jimmyw/soldering_station/solderingcontroller/solderingcontroller.pdf

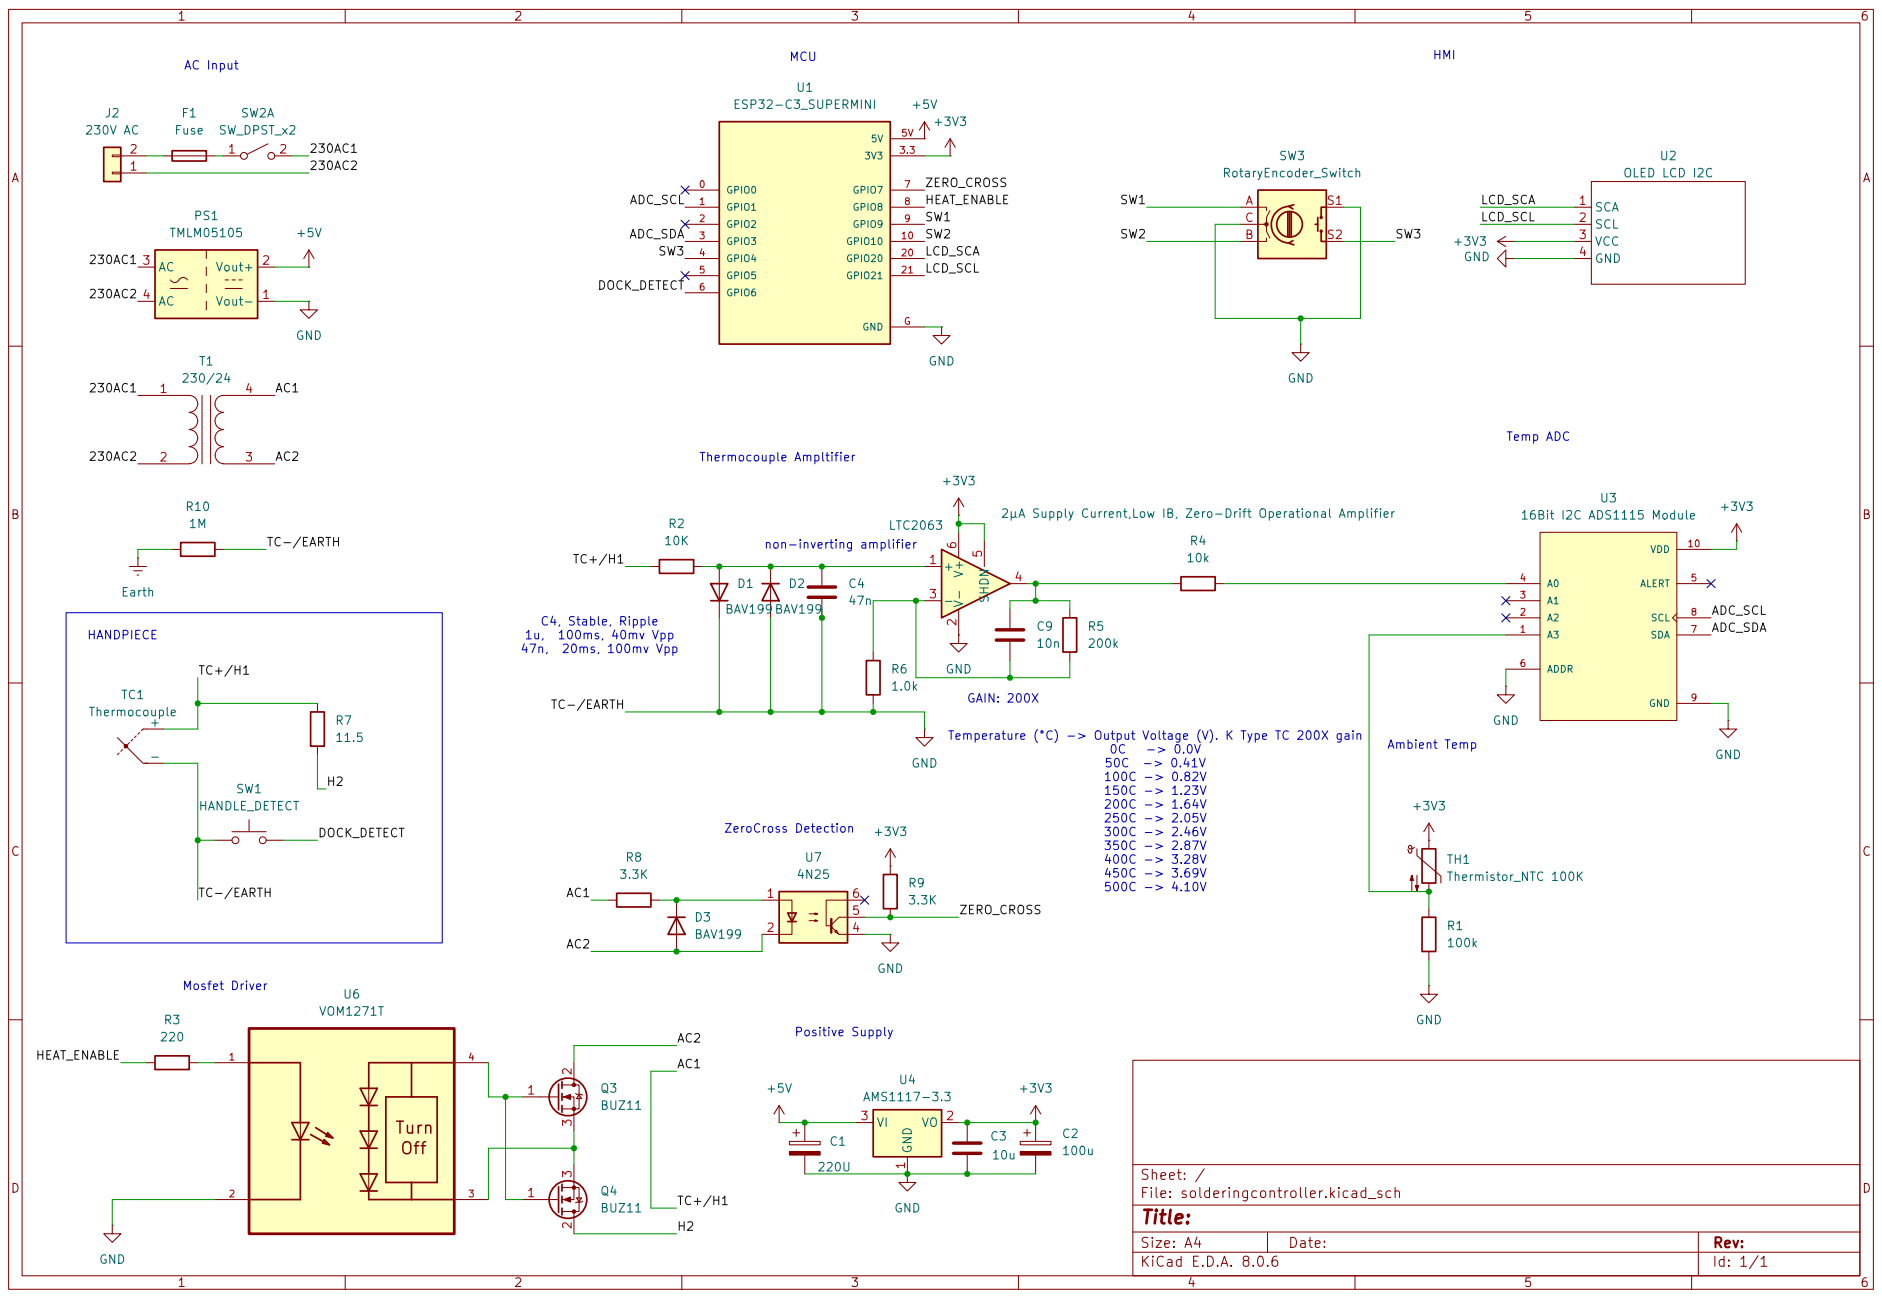
[picture p1: page 1]
