jimmyw/soldering_station/src/test.py

reported_temperature = [160, 150, 140, 130, 120, 110, 100, 90, 80,  70, 60, 50, 40, 30,]
actual_temperature =   [222, 207, 194, 185, 168, 158, 146, 136, 124, 113, 101, 89, 77, 67]

for i in range(6):
    print(b[i]-a[i])
