jimmyw/soldering_station/(commit log)

2024-10-02 Add detect pin
2024-10-12 Compensate thermocouple with ambient temperature
2024-10-13 Initial add
    [solderingcontroller.kicad_pcb, solderingcontroller.kicad_sch]
2024-10-13 Fix misstakes
    [solderingcontroller.kicad_sch]
2024-10-13 Update tc stuff
    [solderingcontroller.kicad_sch]
2024-10-14 Update missing values
    [solderingcontroller.kicad_sch]
2024-10-15 Work on calibration
2024-10-15 Fix some standby issues
    [main.cpp]
2024-10-15 Simplify schematic
    [solderingcontroller.kicad_sch]
2024-10-21 Remove DOCK_DETECT PU
    [solderingcontroller.kicad_sch]
2024-10-21 Add 230V -> 5V power supply
    [solderingcontroller.kicad_sch]
2024-11-21 Dont keep the pin detect pull upp when not needed, as it might intefer with temp reading
2024-11-21 Fix issue with pull up that did not have time to activate
    [main.cpp]
2024-11-21 Add reading debug print
2024-11-21 Dont set power to clear, it just looks bad on lcd
2024-12-02 Bug fix not reseting state timestamp
    [main.cpp]
2024-12-02 Add double adc readings to filter a little better
